jack-greenberg/skittle-pnp/software/images/sample.jpg

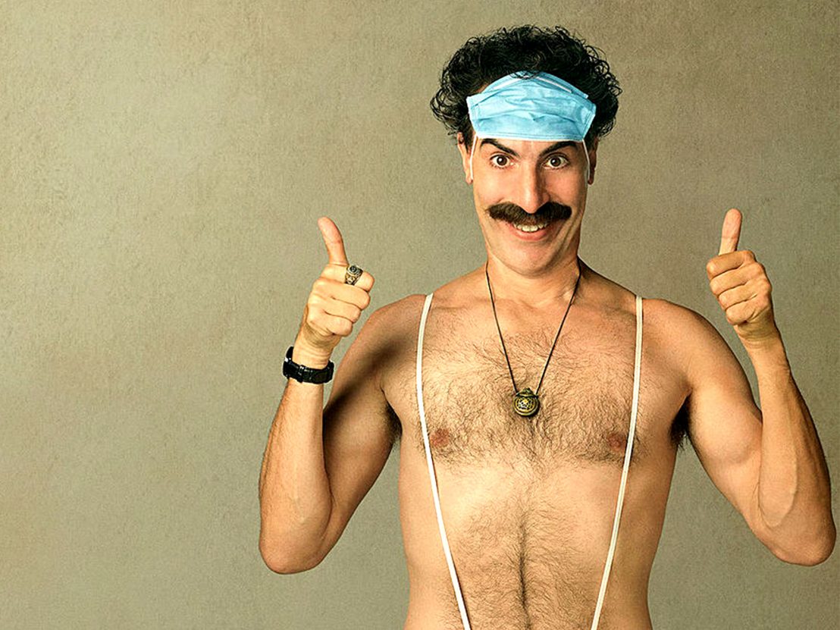
software/images/sample.jpg
