jack-greenberg/skittle-pnp/hardware/main_board/main_board.step

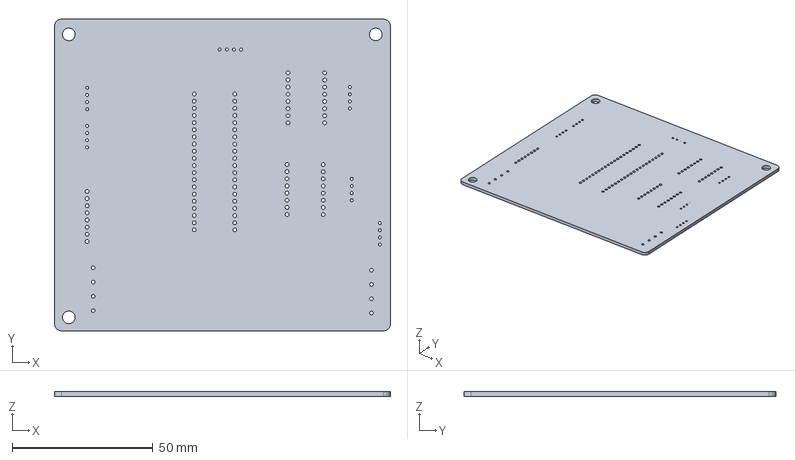
[picture p2: CAD file, 2021-12-13]
hardware/main_board/main_board.step
119.4 x 110.7 x 1.60 mm
