jack-greenberg/skittle-pnp/hardware/main_board/main_board.kicad_pcb

## KiCad design hardware/main_board/main_board.kicad_pcb (2021-12-13)

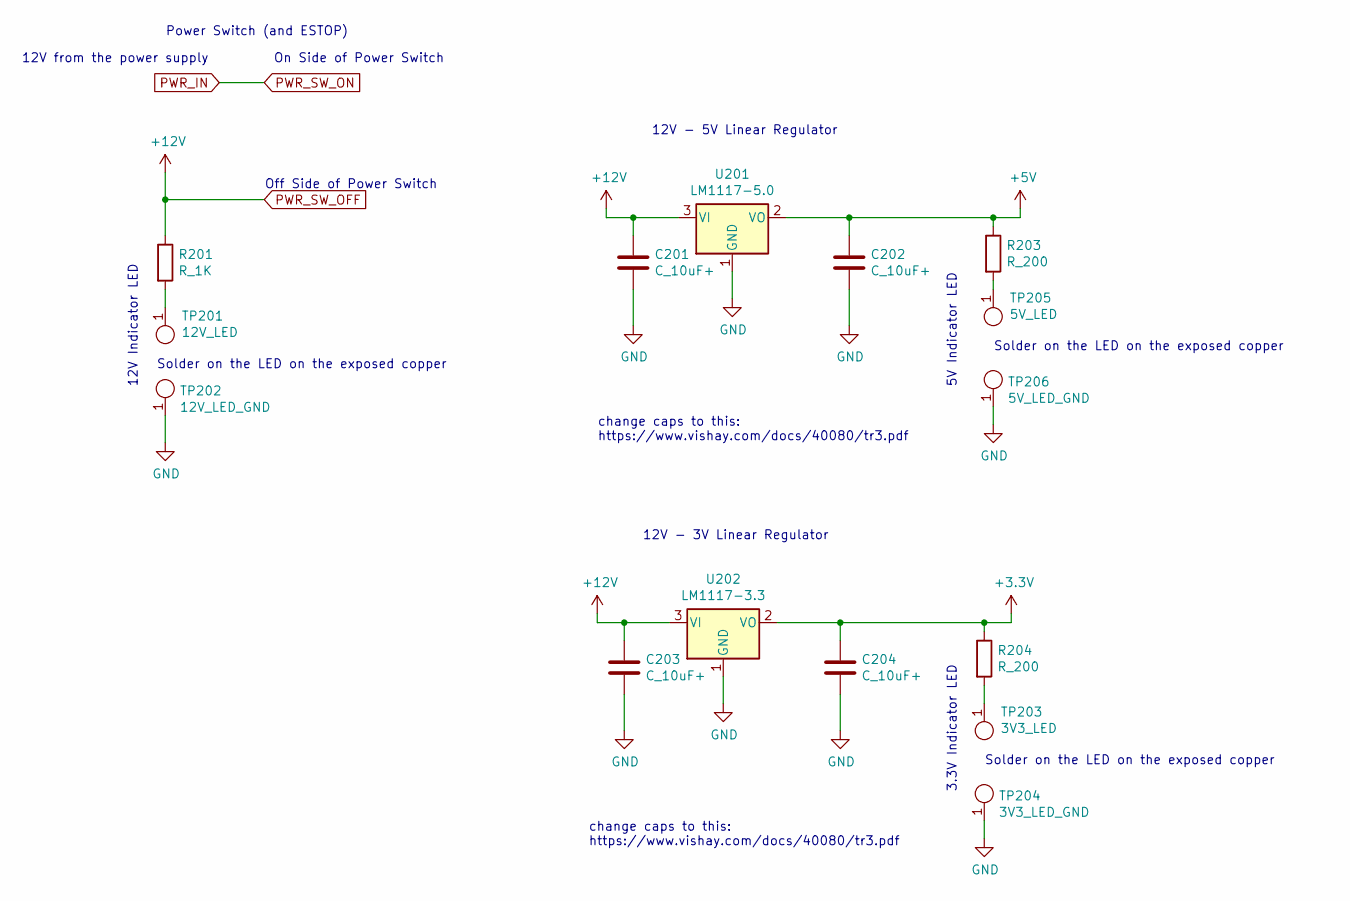
[picture p8: schematic Power.sch]

Parts:
C201, C202, C203, C204: C_10uF+; T491C105K050AT; MPN 718-TR3C106K016C0500CT-ND
R201: R_1K; R_0805_OEM; MPN RNCP0805FTD1K00CT-ND
R203, R204: R_200; R_0805_OEM; MPN RMCF0805JT200RCT-ND
TP201: 12V_LED; Test_Point_SMD
TP202: 12V_LED_GND; Test_Point_SMD
TP203: 3V3_LED; Test_Point_SMD
TP204: 3V3_LED_GND; Test_Point_SMD
TP205: 5V_LED; Test_Point_SMD
TP206: 5V_LED_GND; Test_Point_SMD
U201: LM1117-5.0; SOT230P700X180-4N
U202: LM1117-3.3; SOT230P700X180-4N

Connections:
+3V3: C204.1, R204.1, U202.2 (VO); also elsewhere on the board
+5V: C202.1, R203.1, U201.2 (VO); also elsewhere on the board
GND: C201.2, C202.2, C203.2, C204.2, TP202.1, TP204.1, TP206.1, U201.1 (GND), U202.1 (GND); also elsewhere on the board
unnamed: R201.2, TP201.1
unnamed: R203.2, TP205.1
unnamed: R204.2, TP203.1
PWR_SW_OFF: C201.1, C203.1, R201.1, U201.3 (VI), U202.3 (VI); also elsewhere on the board

Notes on the sheet:
12V - 5V Linear Regulator
Power Switch (and ESTOP)
Off Side of Power Switch
On Side of Power Switch
12V from the power supply
change caps to this: https://www.vishay.com/docs/40080/tr3.pdf
12V - 3V Linear Regulator
12V Indicator LED
3.3V Indicator LED
5V Indicator LED
Solder on the LED on the exposed copper

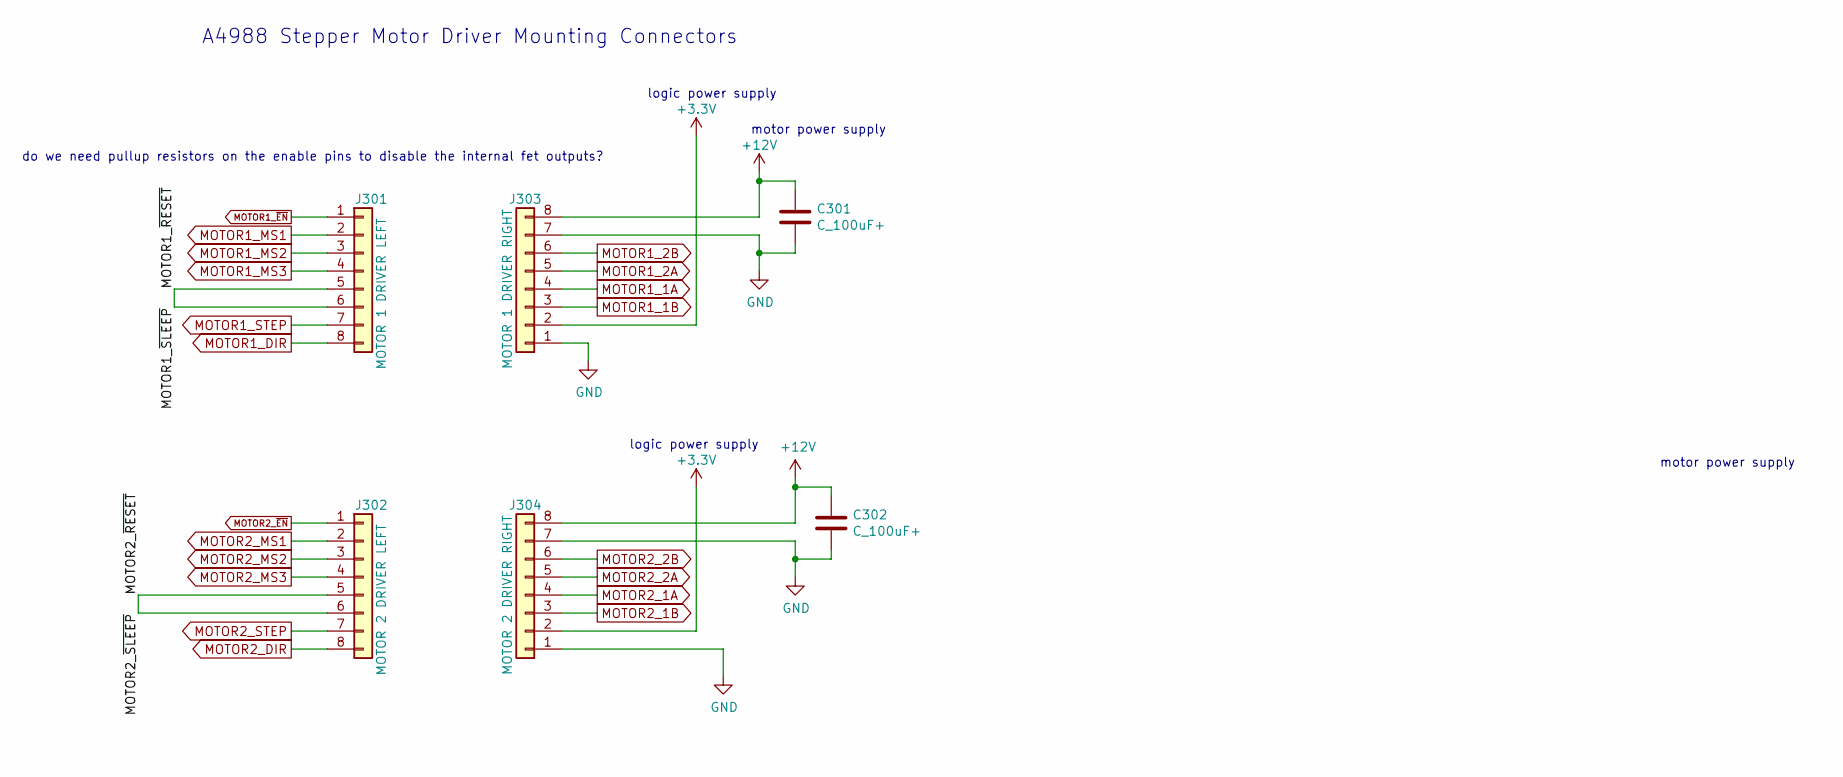
[picture p9: schematic motor_drivers.sch]

Parts:
C301, C302: C_100uF+
J301: MOTOR 1 DRIVER LEFT; RHDR8W80P0X254_1X8_2082X254X850P
J302: MOTOR 2 DRIVER LEFT; RHDR8W80P0X254_1X8_2082X254X850P
J303: MOTOR 1 DRIVER RIGHT; RHDR8W80P0X254_1X8_2082X254X850P
J304: MOTOR 2 DRIVER RIGHT; RHDR8W80P0X254_1X8_2082X254X850P

Connections:
+3V3: J303.2, J304.2; also elsewhere on the board
/Motor Drivers/MOTOR1_~RESET: J301.5, J301.6
/Motor Drivers/MOTOR2_~RESET: J302.5, J302.6
GND: C301.1, C302.1, J303.1, J303.7, J304.1, J304.7; also elsewhere on the board
MOTOR1_1A: J303.4; also elsewhere on the board
MOTOR1_1B: J303.3; also elsewhere on the board
MOTOR1_2A: J303.5; also elsewhere on the board
MOTOR1_2B: J303.6; also elsewhere on the board
MOTOR1_DIR: J301.8; also elsewhere on the board
MOTOR1_MS1: J301.2; also elsewhere on the board
MOTOR1_MS2: J301.3; also elsewhere on the board
MOTOR1_MS3: J301.4; also elsewhere on the board
MOTOR1_STEP: J301.7; also elsewhere on the board
MOTOR1_~EN: J301.1; also elsewhere on the board
MOTOR2_1A: J304.4; also elsewhere on the board
MOTOR2_1B: J304.3; also elsewhere on the board
MOTOR2_2A: J304.5; also elsewhere on the board
MOTOR2_2B: J304.6; also elsewhere on the board
MOTOR2_DIR: J302.8; also elsewhere on the board
MOTOR2_MS1: J302.2; also elsewhere on the board
MOTOR2_MS2: J302.3; also elsewhere on the board
MOTOR2_MS3: J302.4; also elsewhere on the board
MOTOR2_STEP: J302.7; also elsewhere on the board
MOTOR2_~EN: J302.1; also elsewhere on the board
PWR_SW_OFF: C301.2, C302.2, J303.8, J304.8; also elsewhere on the board

Notes on the sheet:
A4988 Stepper Motor Driver Mounting Connectors
logic power supply
motor power supply
do we need pullup resistors on the enable pins to disable the internal fet outputs?

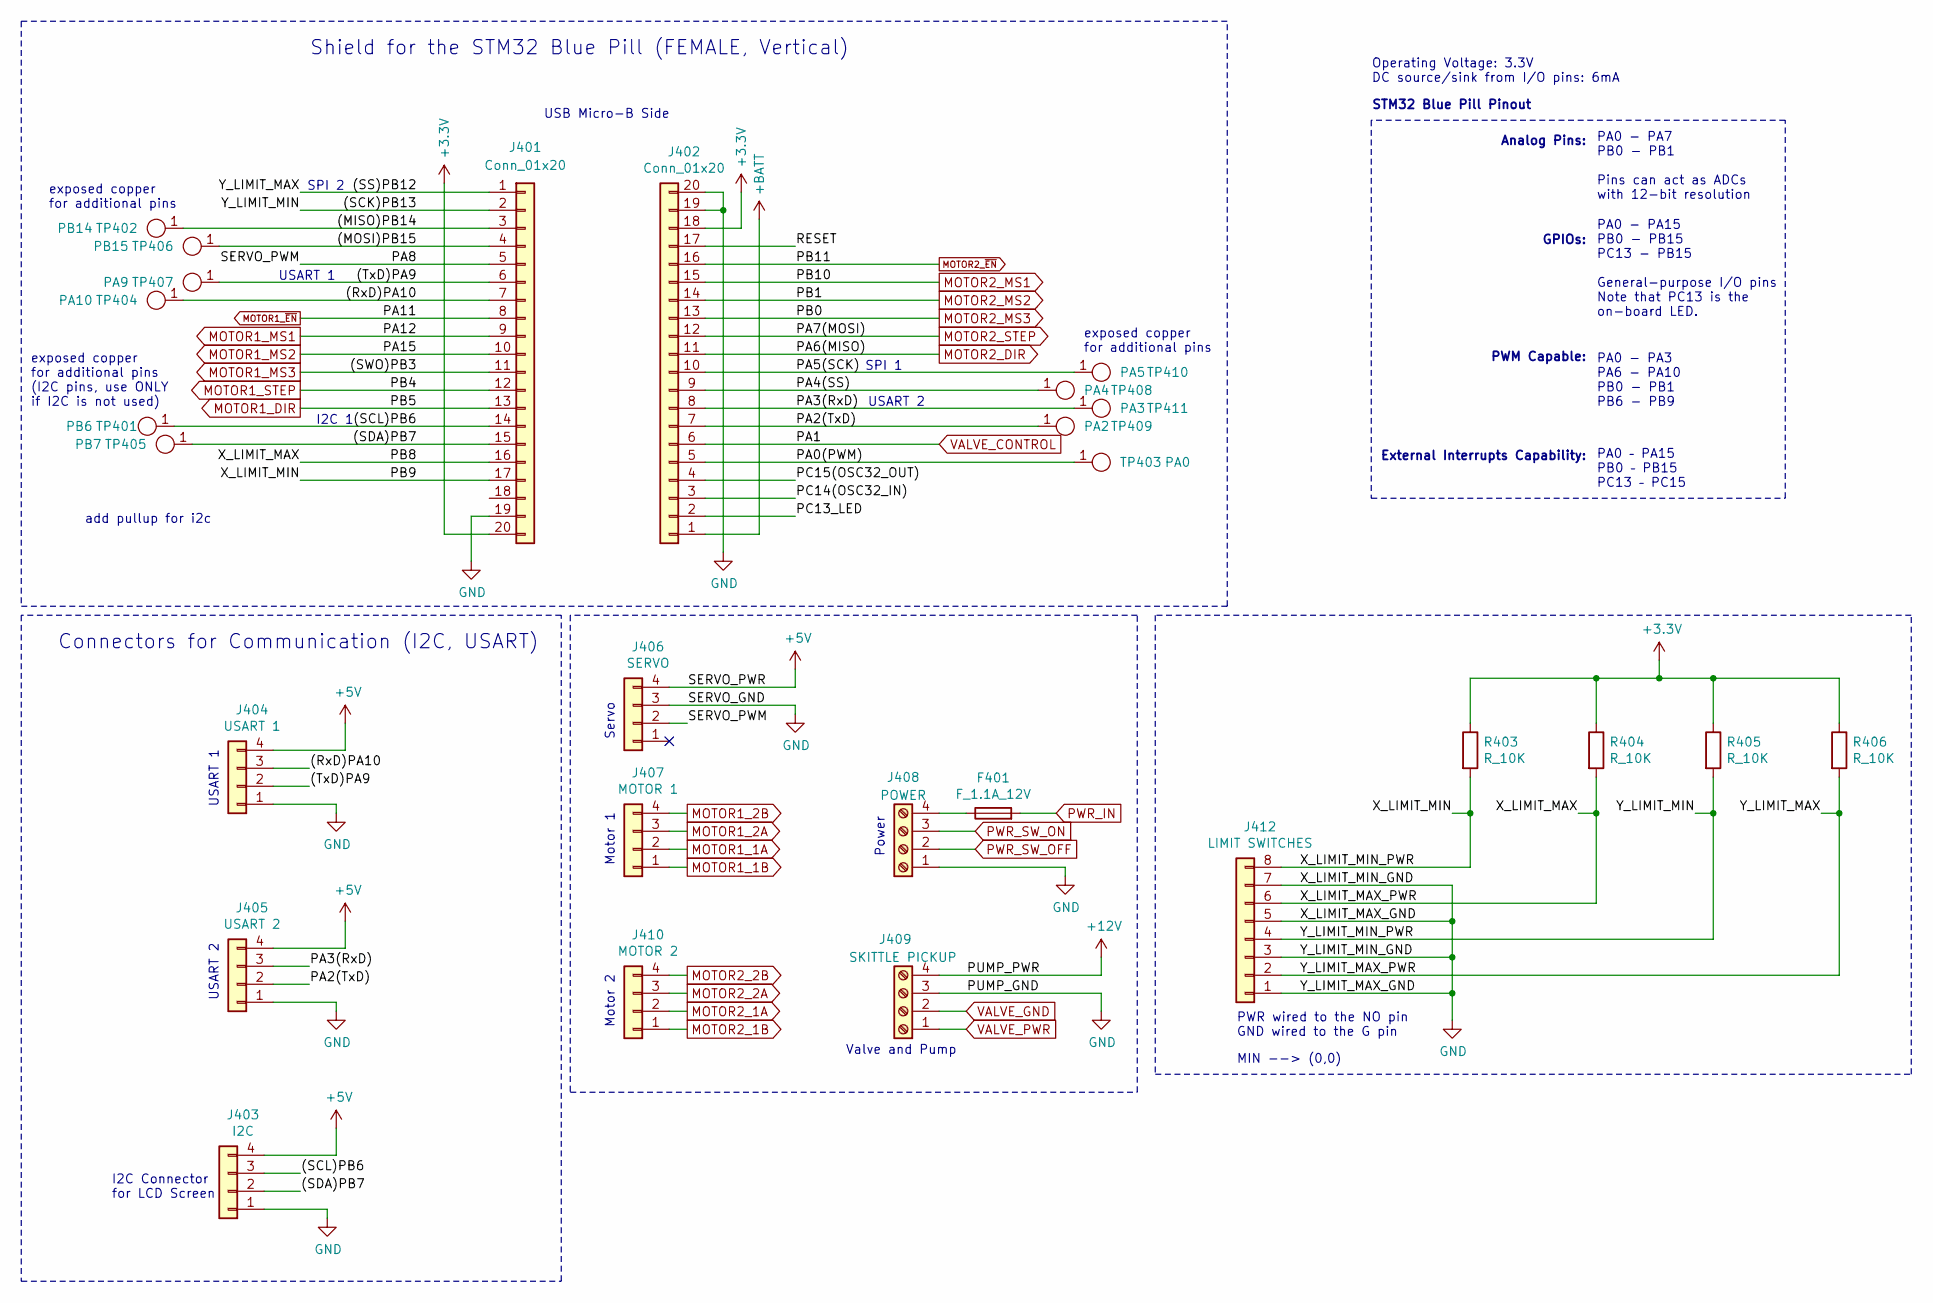
[picture p10: schematic STM32_and_Connectors.sch]

Parts:
F401: F_1.1A_12V; 1206L075SLYR; MPN F5764CT-ND
J401, J402: Conn_01x20; RHDR20W80P0X254_1X20_5130X254X880P
J403: I2C; SULLINS_PPTC041LFBN-RC
J404: USART 1; SULLINS_PPTC041LFBN-RC
J405: USART 2; SULLINS_PPTC041LFBN-RC
J406: SERVO; SULLINS_PPTC041LFBN-RC
J407: MOTOR 1; SULLINS_PPTC041LFBN-RC
J408: POWER; CUI_TB006-508-04BE
J409: SKITTLE PICKUP; CUI_TB006-508-04BE
J410: MOTOR 2; SULLINS_PPTC041LFBN-RC
J412: LIMIT SWITCHES; RHDR8W80P0X254_1X8_2082X254X850P
R403, R404, R405, R406: R_10K; R_0805_OEM; MPN CRS0805-FX-1002ELFCT-ND
TP401: PB6; Test_Point_SMD
TP402: PB14; Test_Point_SMD
TP403: PA0; Test_Point_SMD
TP404: PA10; Test_Point_SMD
TP405: PB7; Test_Point_SMD
TP406: PB15; Test_Point_SMD
TP407: PA9; Test_Point_SMD
TP408: PA4; Test_Point_SMD
TP409: PA2; Test_Point_SMD
TP410: PA5; Test_Point_SMD
TP411: PA3; Test_Point_SMD

Connections:
+3V3: J401.20, J402.18, R403.1, R404.1, R405.1, R406.1; also elsewhere on the board
+5V: J401.18, J403.4, J404.4, J405.4, J406.4; also elsewhere on the board
+BATT: J402.1
/STM32_and_Connectors/(MISO)PB14: J401.3, TP402.1
/STM32_and_Connectors/(MOSI)PB15: J401.4, TP406.1
/STM32_and_Connectors/(RxD)PA10: J401.7, J404.3, TP404.1
/STM32_and_Connectors/(SCK)PB13: J401.2, J412.4, R405.2
/STM32_and_Connectors/(SCL)PB6: J401.14, J403.3, TP401.1
/STM32_and_Connectors/(SDA)PB7: J401.15, J403.2, TP405.1
/STM32_and_Connectors/(SS)PB12: J401.1, J412.2, R406.2
/STM32_and_Connectors/(TxD)PA9: J401.6, J404.2, TP407.1
/STM32_and_Connectors/PA0(PWM): J402.5, TP403.1
/STM32_and_Connectors/PA2(TxD): J402.7, J405.2, TP409.1
/STM32_and_Connectors/PA3(RxD): J402.8, J405.3, TP411.1
/STM32_and_Connectors/PA4(SS): J402.9, TP408.1
/STM32_and_Connectors/PA5(SCK): J402.10, TP410.1
/STM32_and_Connectors/PA8: J401.5, J406.2
/STM32_and_Connectors/PB8: J401.16, J412.6, R404.2
/STM32_and_Connectors/PB9: J401.17, J412.8, R403.2
/STM32_and_Connectors/PC13_LED: J402.2
/STM32_and_Connectors/PC14(OSC32_IN): J402.3
/STM32_and_Connectors/PC15(OSC32_OUT): J402.4
/STM32_and_Connectors/RESET: J402.17
GND: J401.19, J402.19, J402.20, J403.1, J404.1, J405.1, J406.3, J408.1, J409.3, J412.1, J412.3, J412.5, J412.7; also elsewhere on the board
MOTOR1_1A: J407.2; also elsewhere on the board
MOTOR1_1B: J407.1; also elsewhere on the board
MOTOR1_2A: J407.3; also elsewhere on the board
MOTOR1_2B: J407.4; also elsewhere on the board
MOTOR1_DIR: J401.13; also elsewhere on the board
MOTOR1_MS1: J401.9; also elsewhere on the board
MOTOR1_MS2: J401.10; also elsewhere on the board
MOTOR1_MS3: J401.11; also elsewhere on the board
MOTOR1_STEP: J401.12; also elsewhere on the board
MOTOR1_~EN: J401.8; also elsewhere on the board
MOTOR2_1A: J410.2; also elsewhere on the board
MOTOR2_1B: J410.1; also elsewhere on the board
MOTOR2_2A: J410.3; also elsewhere on the board
MOTOR2_2B: J410.4; also elsewhere on the board
MOTOR2_DIR: J402.11; also elsewhere on the board
MOTOR2_MS1: J402.15; also elsewhere on the board
MOTOR2_MS2: J402.14; also elsewhere on the board
MOTOR2_MS3: J402.13; also elsewhere on the board
MOTOR2_STEP: J402.12; also elsewhere on the board
MOTOR2_~EN: J402.16; also elsewhere on the board
unnamed: F401.1, J408.4
PWR_SW_OFF: J408.2, J409.1, J409.4; also elsewhere on the board
VALVE_CONTROL: J402.6; also elsewhere on the board
VALVE_GND: J409.2; also elsewhere on the board

Notes on the sheet:
Shield for the STM32 Blue Pill (FEMALE, Vertical)
USB Micro-B Side
PA0 - PA7 PB0 - PB1 Pins can act as ADCs with 12-bit resolution
Analog Pins:
GPIOs:
PA0 - PA15 PB0 - PB15 PC13 - PB15 General-purpose I/O pins Note that PC13 is the on-board LED.
PWM Capable:
PA0 - PA3 PA6 - PA10 PB0 - PB1 PB6 - PB9
External Interrupts Capability:
PA0 – PA15 PB0 – PB15 PC13 – PC15
STM32 Blue Pill Pinout
USART 1
SPI 1
SPI 2
Operating Voltage: 3.3V DC source/sink from I/O pins: 6mA
I2C 1
USART 2
I2C Connector for LCD Screen
exposed copper for additional pins
exposed copper for additional pins (I2C pins, use ONLY if I2C is not used)
Connectors for Communication (I2C, USART)
PWR wired to the NO pin GND wired to the G pin
MIN --> (0,0)
add pullup for i2c
Motor 2
Motor 1
Servo
Power
Valve and Pump

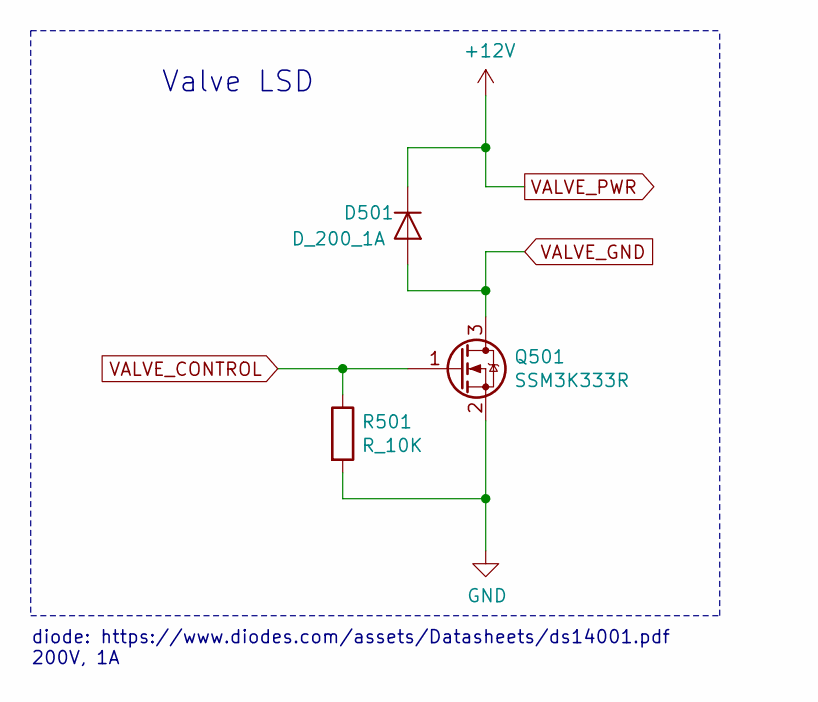
[picture p11: schematic Valve_LSD.sch]

Parts:
D501: D_200_1A; DIOM5226X240N
Q501: SSM3K333R; SOT-23F; MPN SSM3K333RLFCT-ND
R501: R_10K; R_0805_OEM; MPN CRS0805-FX-1002ELFCT-ND

Connections:
GND: Q501.2 (S), R501.2; also elsewhere on the board
PWR_SW_OFF: D501.1 (K); also elsewhere on the board
VALVE_CONTROL: Q501.1 (G), R501.1; also elsewhere on the board
VALVE_GND: D501.2 (A), Q501.3 (D); also elsewhere on the board

Notes on the sheet:
Valve LSD
diode: https://www.diodes.com/assets/Datasheets/ds14001.pdf 200V, 1A

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
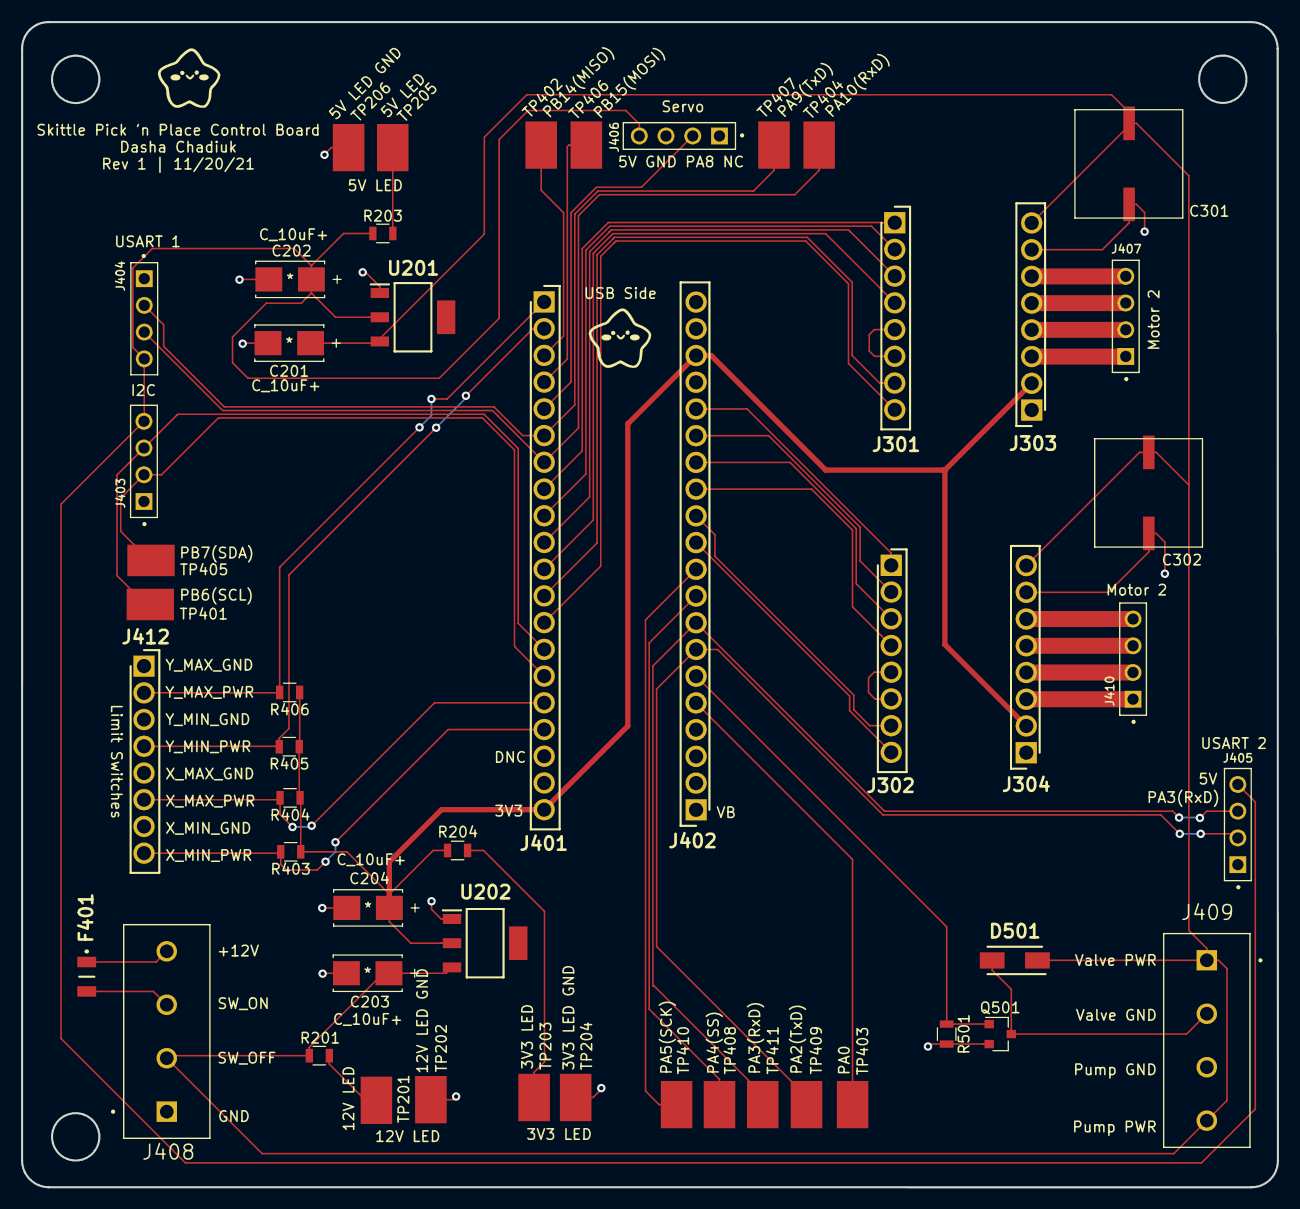
[picture p12: board main_board.kicad_pcb from above]

Board: 2 copper layers, 119.4 x 110.7 mm, 51 parts (0 on the bottom side), 49 nets.
