jack-greenberg/skittle-pnp/firmware/src/pwm.c

/*
 * This file is part of the PWM-Servo example.
 *
 * Copyright (C) 2011 Stefan Wendler <sw@kaltpost.de>
 *
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
 * You should have received a copy of the GNU General Public License
 * along with this program.  If not, see <http://www.gnu.org/licenses/>.
 */

#include <libopencm3/stm32/rcc.h>
#include <libopencm3/stm32/gpio.h>

#include "pwm.h"

void pwm_init_timer(volatile uint32_t *reg, uint32_t en, uint32_t timer_peripheral, uint32_t prescaler, uint32_t period)
{
    /* Enable timer clock. */
    rcc_periph_clock_enable(RCC_TIM1);
    rcc_periph_clock_enable(RCC_TIM4);

    /* Set the timers global mode to:
    * - use no divider
    * - alignment edge
    * - count direction up
    */
    timer_set_mode(timer_peripheral,
                TIM_CR1_CKD_CK_INT,
                TIM_CR1_CMS_EDGE,
                TIM_CR1_DIR_UP);

    timer_set_prescaler(timer_peripheral, prescaler);
    timer_set_repetition_counter(timer_peripheral, 0);
    timer_enable_preload(timer_peripheral);
    timer_continuous_mode(timer_peripheral);
    timer_set_period(timer_peripheral, period);
    
    timer_enable_break_main_output(TIM1);
    timer_enable_counter(TIM1);
}

void pwm_init_output_channel(uint32_t timer_peripheral, enum tim_oc_id oc_id, volatile uint32_t *gpio_reg, uint32_t gpio_en, uint32_t gpio_port, uint16_t gpio_pin)
{
    /* Enable GPIO clock. */
    rcc_peripheral_enable_clock(gpio_reg, gpio_en);

    /* Set timer channel to output */
    gpio_set_mode(gpio_port, GPIO_MODE_OUTPUT_50_MHZ,
               GPIO_CNF_OUTPUT_ALTFN_PUSHPULL,
               gpio_pin);

    timer_disable_oc_output(timer_peripheral, oc_id);
    timer_disable_oc_output(TIM1, TIM_OC3N);
    timer_set_oc_mode(timer_peripheral, oc_id, TIM_OCM_PWM1);
    timer_set_oc_value(timer_peripheral, oc_id, 0);
    timer_enable_oc_output(timer_peripheral, oc_id);
}

void pwm_set_pulse_width(uint32_t timer_peripheral, enum tim_oc_id oc_id, uint32_t pulse_width)
{
     timer_set_oc_value(timer_peripheral, oc_id, pulse_width);
}

void pwm_start_timer(uint32_t timer_peripheral)
{
     timer_enable_counter(timer_peripheral);
}
