jack-greenberg/skittle-pnp/(commit log)

2021-11-02 Add initial prototype 1 code
2021-11-03 Add error checking for parser
    [command.cpp, prototype-1.ino]
2021-11-03 Fix command/wait for ok order
    [motion_control.py]
2021-11-17 completed main interface board
    [Connectors.sch, Power.sch, STM32_and_Connectors.sch, main_board.kicad_pcb, main_board.sch, motor_drivers.sch]
2021-11-17 changed order of servo connections
    [STM32_and_Connectors.sch]
2021-11-17 fixed valve lsd circuit
    [STM32_and_Connectors.sch]
2021-11-17 added connector for powering limit switches
    [Power.sch, STM32_and_Connectors.sch]
2021-11-17 Use the most current image processing script
2021-11-17 Add 500us timer integration
2021-11-17 Added skittle_pnp symbol and footprint library
    Added 10uF tantalum capacitor and diode to the
    skittle_pnp symbol and footprints libraries.
    [Power.sch, STM32_and_Connectors.sch, Valve_LSD.sch, main_board.sch, motor_drivers.sch]
2021-12-01 Fix EXTI interrupts for limit switches
    [actuate.c, main.c]
2021-12-01 Fix movement and add homing command
    [actuate.c, actuate.h, gcode.c, gcode.h, main.c]
2021-12-03 Integrate servo code
2021-12-03 final schematic and layout
    [Power.sch, STM32_and_Connectors.sch, Valve_LSD.sch, motor_drivers.sch]
2021-12-04 Fix (hopefully) EXTI interrupts
    [actuate.c, main.c]
2021-12-08 added step file for pcb
    [main_board.step]
2021-12-11 Add servo structs and tweak speeds
2021-12-12 Update PWM pins
2021-12-13 Add working python script and sample image
2021-12-13 added final schematic and layout
    [STM32_and_Connectors.sch, main_board.csv]
